oyontalas/g474_DianSai2023/docs/G474-带仿真器原理图(1).pdf

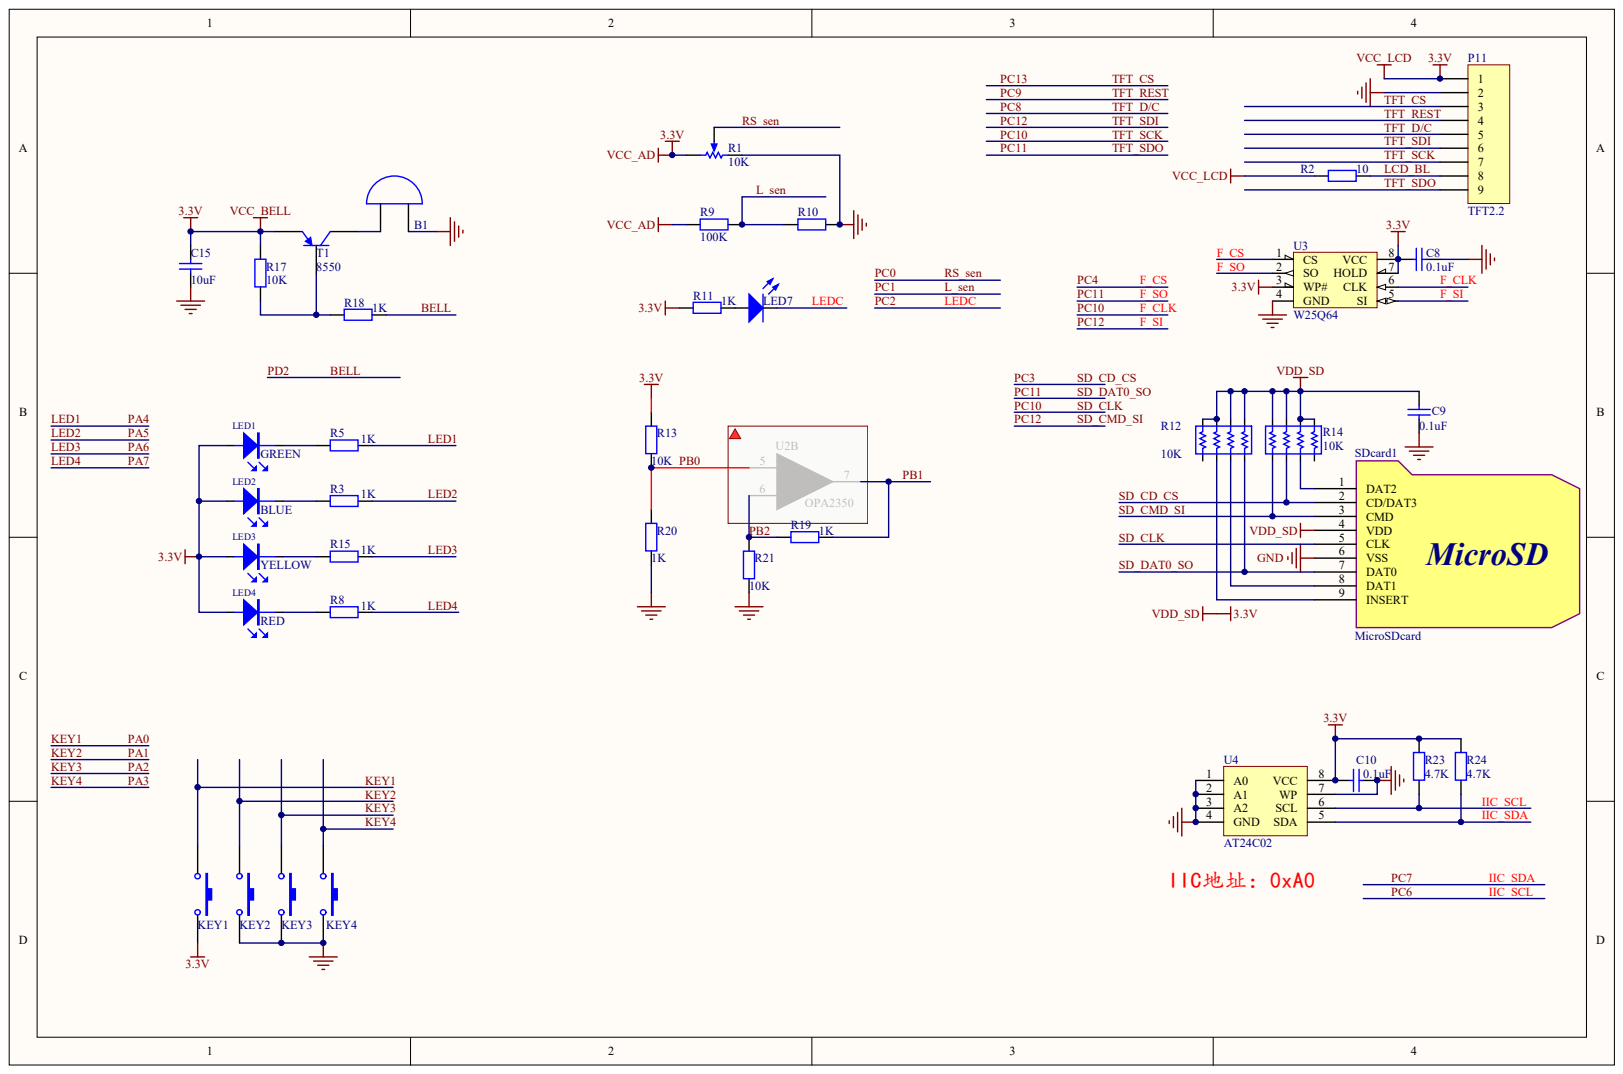
[picture p2: page 1]

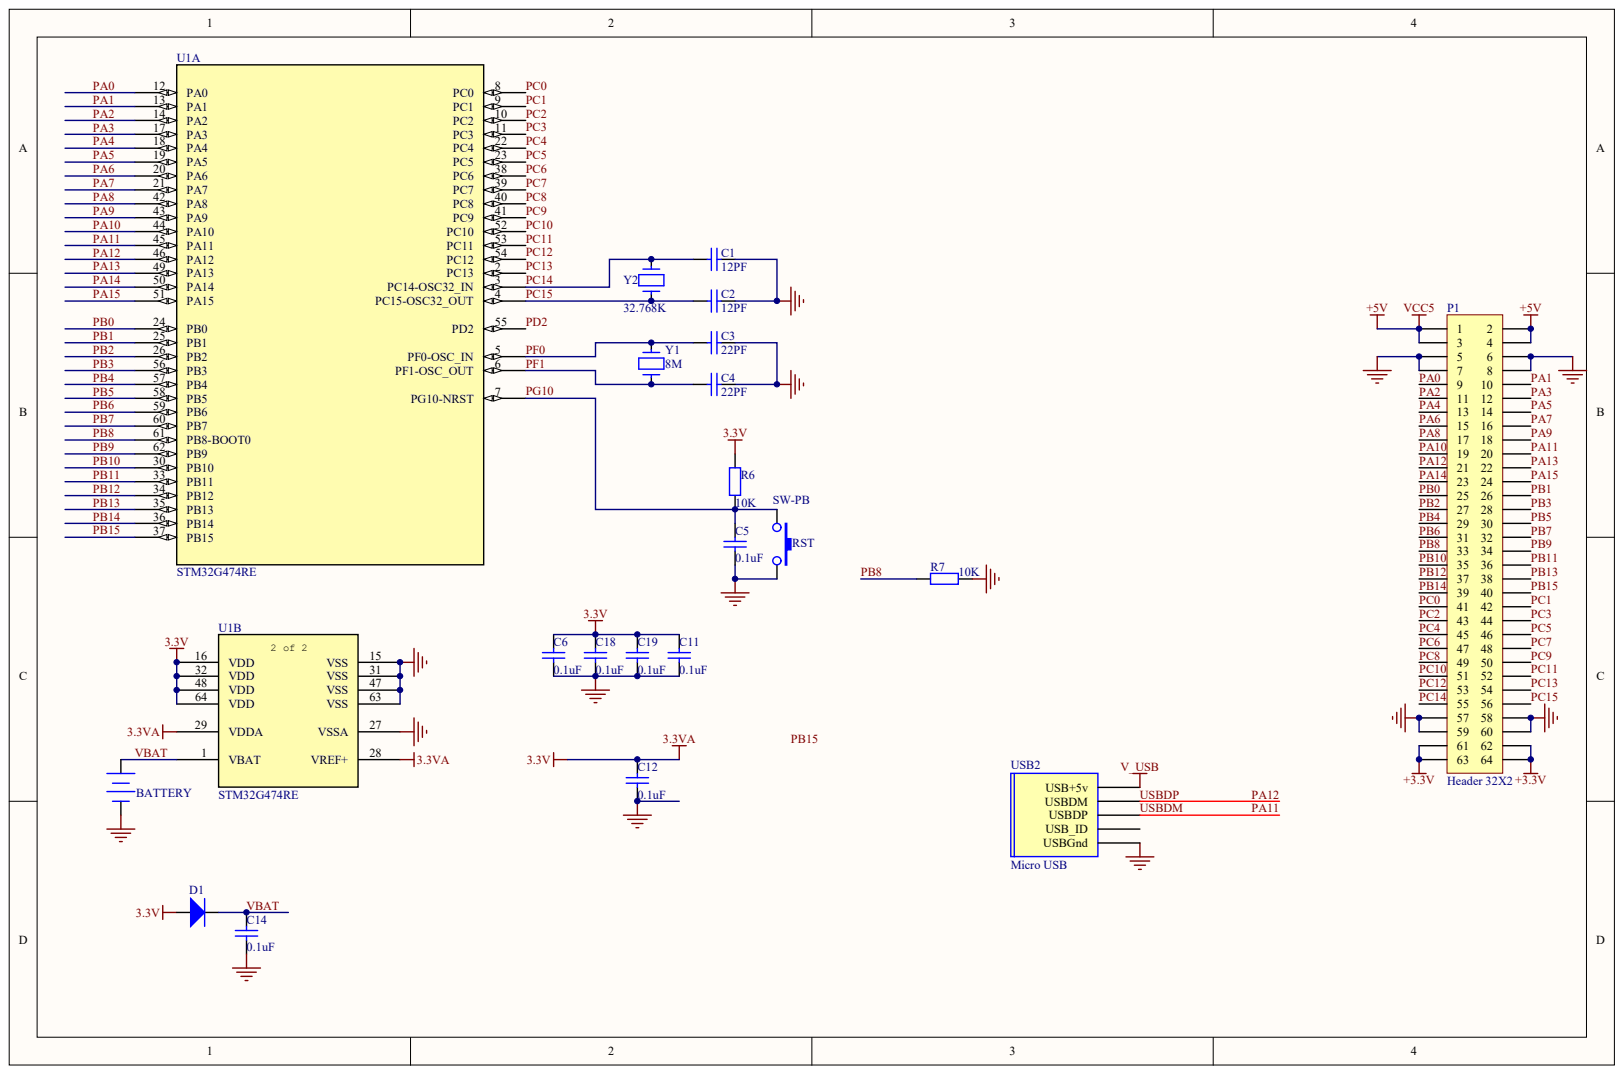
[picture p3: page 2]

PF0 Y1
6 PF1 | | 8M

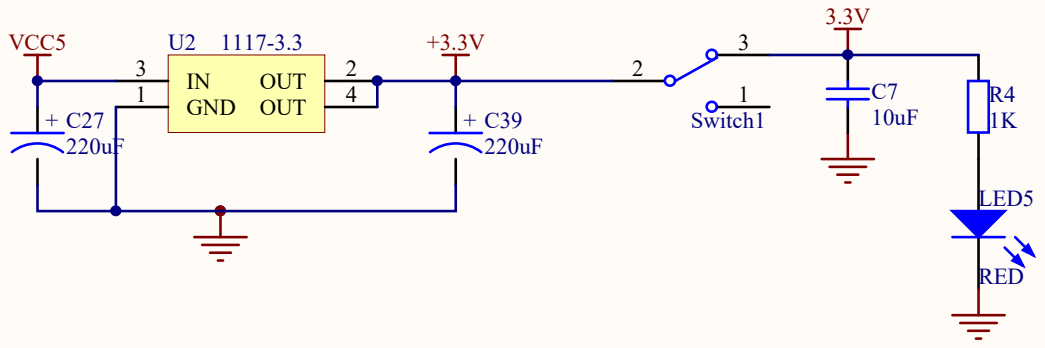
[picture p4: page 3]

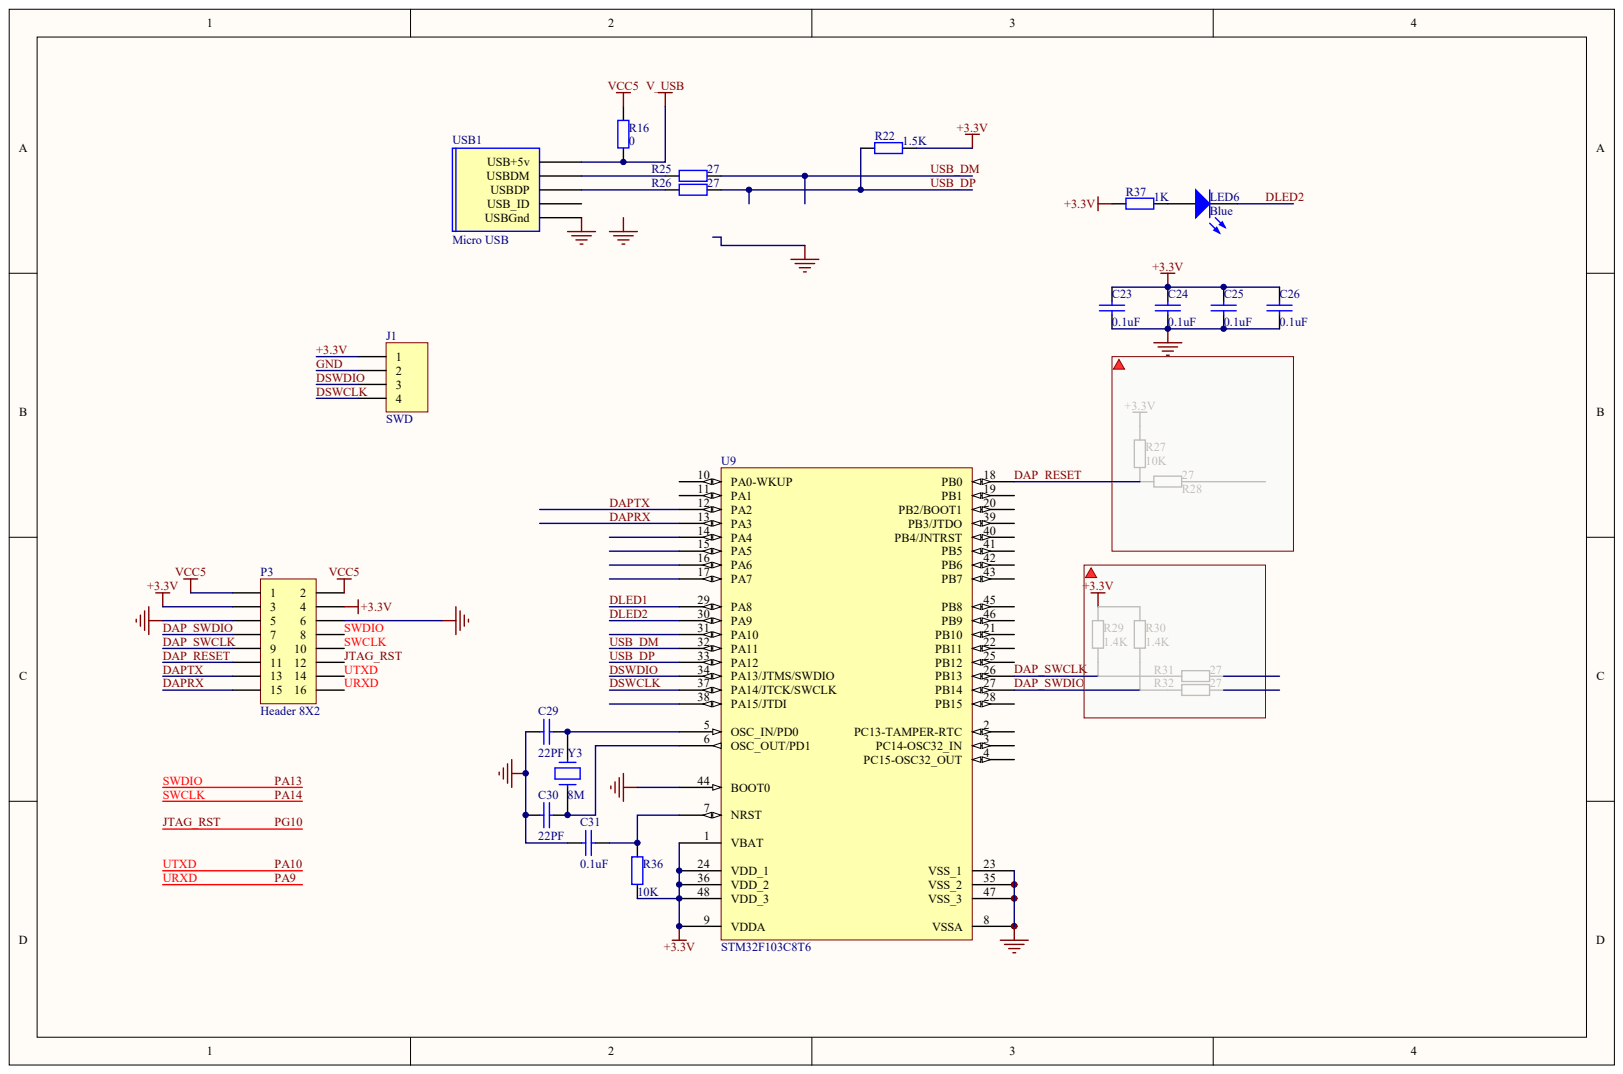
[picture p5: page 4]

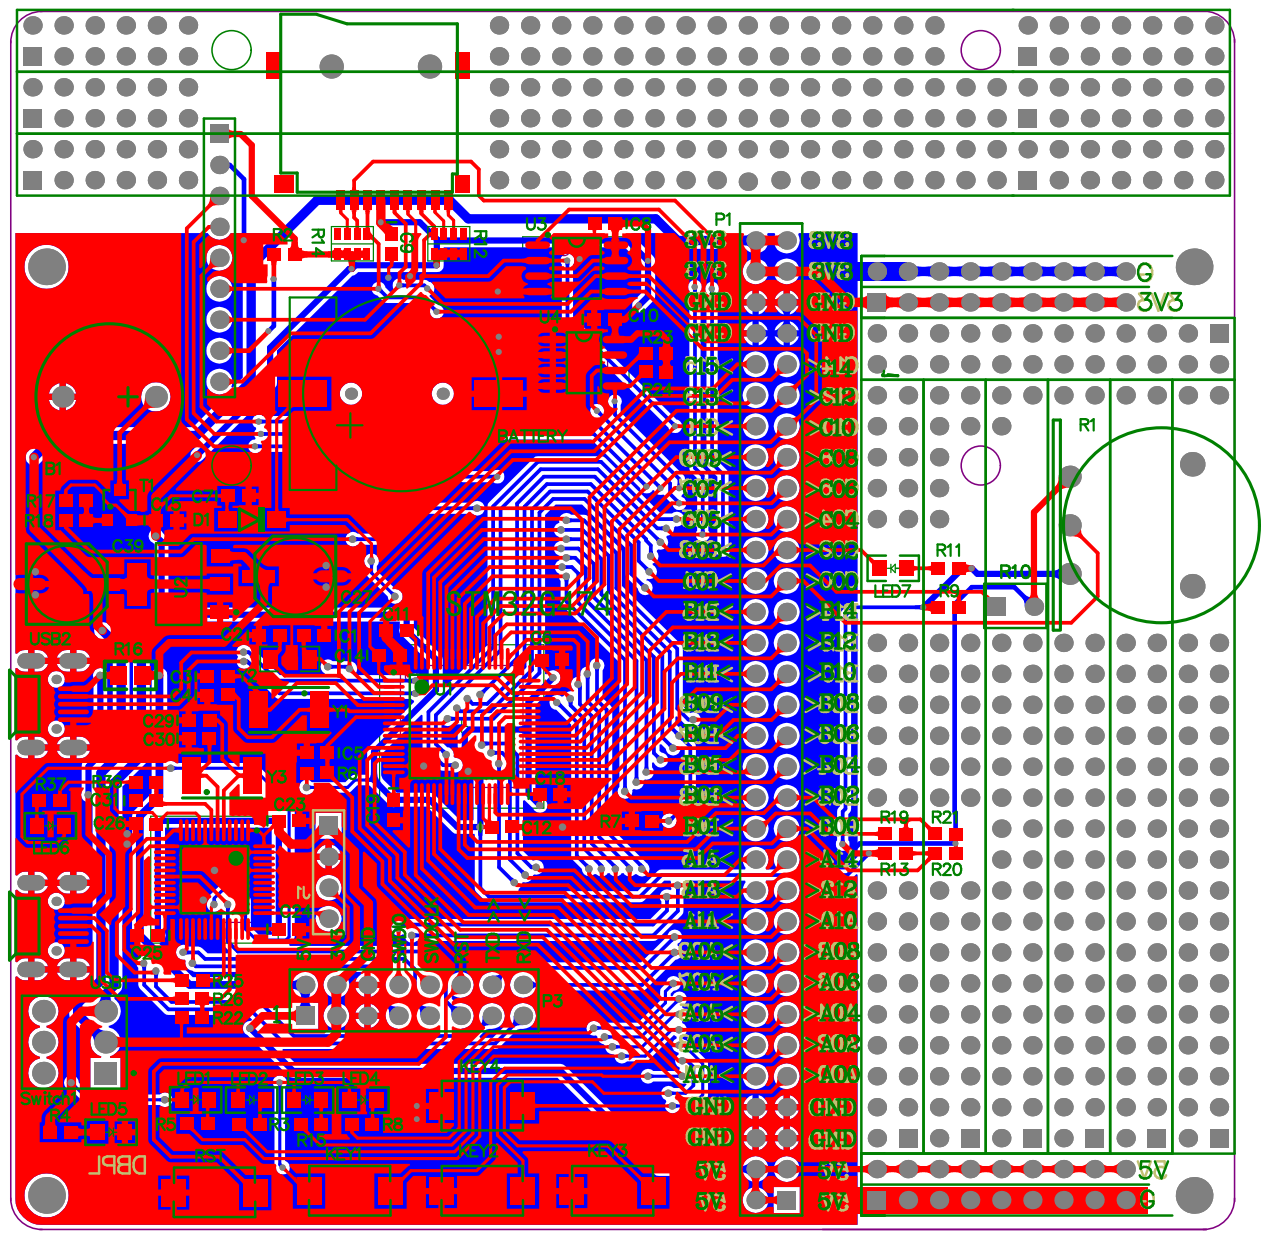
[picture p6: page 5]
