oyontalas/g474_DianSai2023/g474_DianSai2023.ioc

Mcu.UserName=STM32G474RETx
PA0.GPIO_Label=KEY1
PA0.Signal=GPIO_Input
PA1.GPIO_Label=KEY2
PA1.Signal=GPIO_Input
PA10.Signal=USART1_RX
PA13.GPIO_Label=T_SWDIO
PA13.Signal=SYS_JTMS-SWDIO
PA14.GPIO_Label=T_SWCLK
PA14.Signal=SYS_JTCK-SWCLK
PA2.GPIO_Label=KEY3
PA2.Signal=GPIO_Input
PA3.GPIO_Label=KEY4
PA3.Signal=GPIO_Input
PA4.GPIO_Label=LED1
PA4.Signal=GPIO_Output
PA5.GPIO_Label=LED2
PA5.Signal=GPIO_Output
PA6.GPIO_Label=LED3
PA6.Signal=GPIO_Output
PA7.GPIO_Label=LED4
PA7.Signal=GPIO_Output
PA9.Signal=USART1_TX
PB10.Signal=USART3_TX
PB11.Signal=GPIO_Output
PB12.Signal=GPIO_Output
PB13.Signal=SPI2_SCK
PB15.Signal=SPI2_MOSI
PB3.GPIO_Label=T_SWO
PB3.Signal=SYS_JTDO-SWO
PC0.Signal=ADC2_IN6
PC1.Signal=ADC2_IN7
PC10.Signal=SPI3_SCK
PC11.Signal=USART3_RX
PC12.Signal=SPI3_MOSI
PC14-OSC32_IN.Signal=RCC_OSC32_IN
PC15-OSC32_OUT.Signal=RCC_OSC32_OUT
PC2.Signal=ADC1_IN8
PC3.Signal=ADC1_IN9
PC5.Signal=GPIO_Output
PC7.Signal=GPIO_Output
PC8.Signal=GPIO_Output
PC9.Signal=GPIO_Output
PF0-OSC_IN.Signal=RCC_OSC_IN
PF1-OSC_OUT.Signal=RCC_OSC_OUT
