oyontalas/g474_DianSai2023/Core/Inc/main.h

#define KEY1_Pin GPIO_PIN_0
#define KEY1_GPIO_Port GPIOA
#define KEY2_Pin GPIO_PIN_1
#define KEY2_GPIO_Port GPIOA
#define KEY3_Pin GPIO_PIN_2
#define KEY3_GPIO_Port GPIOA
#define KEY4_Pin GPIO_PIN_3
#define KEY4_GPIO_Port GPIOA
#define LED1_Pin GPIO_PIN_4
#define LED1_GPIO_Port GPIOA
#define LED2_Pin GPIO_PIN_5
#define LED2_GPIO_Port GPIOA
#define LED3_Pin GPIO_PIN_6
#define LED3_GPIO_Port GPIOA
#define LED4_Pin GPIO_PIN_7
#define LED4_GPIO_Port GPIOA
#define T_SWDIO_Pin GPIO_PIN_13
#define T_SWDIO_GPIO_Port GPIOA
#define T_SWCLK_Pin GPIO_PIN_14
#define T_SWCLK_GPIO_Port GPIOA
#define T_SWO_Pin GPIO_PIN_3
#define T_SWO_GPIO_Port GPIOB
