oyontalas/g474_DianSai2023/admin/ad9833.c

#include "spi.h"
#include "gpio.h"
#include "ad9833.h"


// 时钟速率为25 MHz时， 可以实现0.1 Hz的分辨率；而时钟速率为1 MHz时，则可以实现0.004 Hz的分辨率。
// 调整参考时钟修改此处即可。
#define FCLK 25000000 // 设置参考时钟25MHz，板默认板载晶振频率25Mhz。

#define RealFreDat 268435456.0 / FCLK // 总的公式为 Fout=（Fclk/2的28次方）*28位寄存器的值

// 两片 DDS 共用 SPI2；0 选 PB11 对应低频 A，1 选 PB12 对应高频 B。
// 调用频率/相位接口前先选芯片；这与芯片内部 FREQ0/FREQ1 寄存器编号不同。
uint8_t AD9833_CS_Select = 0;

/*
***********************************************************************
*	函 数 名: AD9833_CS
*	功能说明: AD9833片选控制
*	形    参: 无
*	返 回 值: 无
************************************************************************
*/
void AD9833_CS(uint8_t AD9833_CS)
{
	if (AD9833_CS_Select == 0)
	{
		if(AD9833_CS){
			HAL_GPIO_WritePin(GPIOB, GPIO_PIN_11, GPIO_PIN_SET);
		}
		else{
			HAL_GPIO_WritePin(GPIOB, GPIO_PIN_11, GPIO_PIN_RESET);
		}
	}
	else if (AD9833_CS_Select == 1)
	{
		if(AD9833_CS){
			HAL_GPIO_WritePin(GPIOB, GPIO_PIN_12, GPIO_PIN_SET);
		}
		else{
			HAL_GPIO_WritePin(GPIOB, GPIO_PIN_12, GPIO_PIN_RESET);
		}
	}
}


/*
***********************************************************************
*	函 数 名: AD9833_GPIOinit
*	功能说明: 初始化AD9833相关GPIO
*	形    参: 无
*	返 回 值: 无
************************************************************************
*/



/*
***********************************************************************
*	函 数 名: AD9833_GPIOinit
*	功能说明: 初始化AD9833相关GPIO
*	形    参: 无
*	返 回 值: 无
************************************************************************
*/
void AD9833_GPIOinit(void)
{
	AD9833_CS(1);
	AD9833_SetRegisterValue(AD9833_REG_CMD | AD9833_RESET);
}

/**********************************************************************************************
** 函数名称 ：unsigned char AD9833_SPI_Write(unsigned char* data,unsigned char bytesNumber)
** 函数功能 ：使用模拟SPI向AD9833写数据
** 入口参数 ：* data:写入数据缓冲区,第一个字节是寄存器地址；第二个字节开始要写入的数据。
						bytesNumber: 要写入的字节数
** 出口参数 ：无
** 函数说明 ：无
************************************************************************************************/
unsigned char AD9833_SPI_Write(unsigned char *data, unsigned char bytesNumber)
{
	unsigned char i, j;
	unsigned char writeData[5] = {0, 0, 0, 0, 0};

	// AD9833_SCLK=1;
	// AD9833_FSYNC=0 ;

	for (i = 0; i < bytesNumber; i++)
	{
		writeData[i] = data[i + 1];
	}
	AD9833_CS(0);
	HAL_SPI_Transmit(&hspi2, writeData, 2, 0x02);
	AD9833_CS(1);
	// for(i=0 ;i<bytesNumber ;i++)
	// {
	// for(j=0 ;j<8 ;j++)
	// 	{
	//     if(writeData[i] & 0x80)
	//       AD9833_SDATA=1;
	//     else
	//       AD9833_SDATA=0;

	//     AD9833_SCLK=0;
	//     writeData[i] <<= 1;
	//     AD9833_SCLK=1;
	// }
	// }
	// AD9833_SDATA=1;
	// AD9833_FSYNC=1;

	return i;
}

/*****************************************************************************************
** 函数名称 ：void AD9833_Reset(void)
** 函数功能 ：设置AD9833的复位位
** 入口参数 ：无
** 出口参数 ：无
** 函数说明 ：无
*******************************************************************************************/
void AD9833_Reset(void)
{
	AD9833_SetRegisterValue(AD9833_REG_CMD | AD9833_RESET);
	HAL_Delay(10);
}

/*****************************************************************************************
** 函数名称 ：void AD9833_ClearReset(void)
** 函数功能 ：清除AD9833的复位位。
** 入口参数 ：无
** 出口参数 ：无
** 函数说明 ：无
*******************************************************************************************/
void AD9833_ClearReset(void)
{
	AD9833_SetRegisterValue(AD9833_REG_CMD);
}
/*
***********************************************************************
*	函 数 名: AD9833_Write
*	功能说明: 向AD9833发送一个16bit数
*	形    参: TxData 要发送的数
*	返 回 值: 无
************************************************************************
*/
void AD9833_SetRegisterValue(unsigned short regValue)
{
	unsigned char data[5] = {0x03, 0x00, 0x00};
	data[1] = (unsigned char)((regValue & 0xFF00) >> 8);
	data[2] = (unsigned char)((regValue & 0x00FF) >> 0);
	AD9833_SPI_Write(data, 2);
}

/*****************************************************************************************
** 函数名称 ：void AD9833_SetFrequencyQuick(float fout,unsigned short type)
** 函数功能 ：写入频率寄存器
** 入口参数 ：val：要写入的频率值。
**						type：波形类型；AD9833_OUT_SINUS正弦波、AD9833_OUT_TRIANGLE三角波、AD9833_OUT_MSB方波
** 出口参数 ：无
** 函数说明 ：时钟速率为25 MHz时， 可以实现0.1 Hz的分辨率；而时钟速率为1 MHz时，则可以实现0.004 Hz的分辨率。
*******************************************************************************************/
void AD9833_SetFrequencyQuick(float fout, unsigned short type)
{
	// 本工程两路输出分别使用两片芯片的 FREQ0，不是同一芯片的两个频率寄存器。
	AD9833_SetFrequency(AD9833_REG_FREQ0, fout, type);
}

/*****************************************************************************************
** 函数名称 ：void AD9833_SetFrequency(unsigned short reg, float fout,unsigned short type)
** 函数功能 ：写入频率寄存器
** 入口参数 ：reg：要写入的频率寄存器。
**						val：要写入的值。
**						type：波形类型；AD9833_OUT_SINUS正弦波、AD9833_OUT_TRIANGLE三角波、AD9833_OUT_MSB方波
** 出口参数 ：无
** 函数说明 ：无
*******************************************************************************************/
void AD9833_SetFrequency(unsigned short reg, float fout, unsigned short type)
{
	unsigned short freqHi = reg;
	unsigned short freqLo = reg;
	// fout 单位为 Hz：28 位调谐字 = fout * 2^28 / FCLK，转整数时截去小数。
	// FCLK 应与 DDS 实际参考时钟一致，否则归整后的题目频率仍会产生输出偏差。
	unsigned long val = RealFreDat * fout;
	freqHi |= (val & 0xFFFC000) >> 14;
	freqLo |= (val & 0x3FFF);
	// B28 允许完整写入 28 位频率字，依次发送低 14 位和高 14 位；type 选择波形。
	AD9833_SetRegisterValue(AD9833_B28 | type);
	AD9833_SetRegisterValue(freqLo);
	AD9833_SetRegisterValue(freqHi);
}

/*****************************************************************************************
** 函数名称 ：void AD9833_SetPhase(unsigned short reg, unsigned short val)
** 函数功能 ：写入相位寄存器。
** 入口参数 ：reg：要写入的相位寄存器。
**						val：要写入的值。
** 出口参数 ：无
** 函数说明 ：无
*******************************************************************************************/
void AD9833_SetPhase(unsigned short reg, unsigned short val)
{
	// val 是 12 位相位码（0..4095），不是角度；一周为 4096 码，回绕由调用者负责。
	// 题目反馈使用 PHASE0，只写相位寄存器，频率与波形配置保持原值。
	unsigned short phase = reg;
	phase |= val;
	AD9833_SetRegisterValue(phase);
}

/*****************************************************************************************
** 函数名称 ：void AD9833_Setup(unsigned short freq, unsigned short phase,unsigned short type)
** 函数功能 ：写入相位寄存器。
** 入口参数 ：freq：使用的频率寄存器。
							phase：使用的相位寄存器。
							type：要输出的波形类型。
** 出口参数 ：无
** 函数说明 ：无
*******************************************************************************************/
void AD9833_Setup(unsigned short freq, unsigned short phase, unsigned short type)
{
	unsigned short val = 0;

	val = freq | phase | type;
	AD9833_SetRegisterValue(val);
}

/*****************************************************************************************
** 函数名称 ：void AD9833_SetWave(unsigned short type)
** 函数功能 ：设置要输出的波形类型。
** 入口参数 ：type：要输出的波形类型。
** 出口参数 ：无
** 函数说明 ：无
*******************************************************************************************/
void AD9833_SetWave(unsigned short type)
{
	AD9833_SetRegisterValue(type);
}
