oyontalas/g474_DianSai2023/(commit log)

2023-08-04 基础加发挥项目
2026-11-02 docs: 添加项目说明与信号分离方案配图
2026-11-02 docs: 添加 README 作者链接
2026-11-02 docs: 完善信号分离算法注释与 README 说明
